MJSBikes97/roco222/robot_project/models/Arm Segment_2 v3.stl

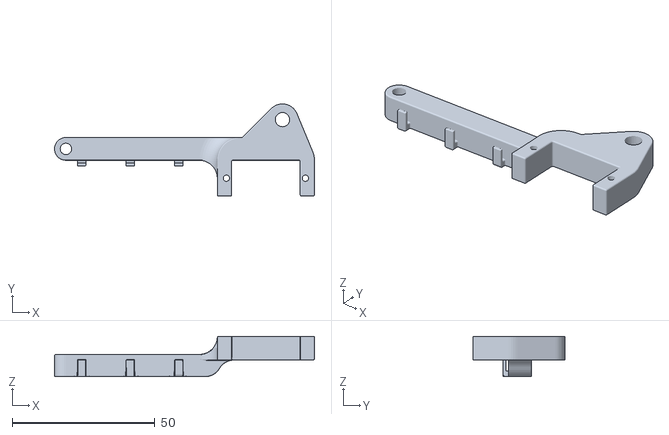
[picture p31: CAD file, 2018-01-10]
robot_project/models/Arm Segment_2 v3.stl
91.0 x 32.2 x 14.1
