MJSBikes97/roco222/robot_project/models/Spur Gear21.stl

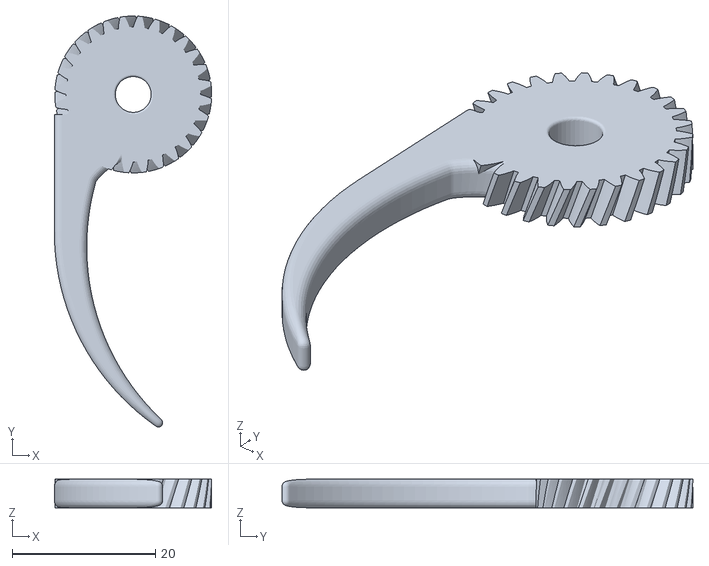
[picture p32: CAD file, 2018-01-10]
robot_project/models/Spur Gear21.stl
21.9 x 57.3 x 4.00
