MJSBikes97/roco222/robot_project/models/Arm_base_spacer_v1.stl

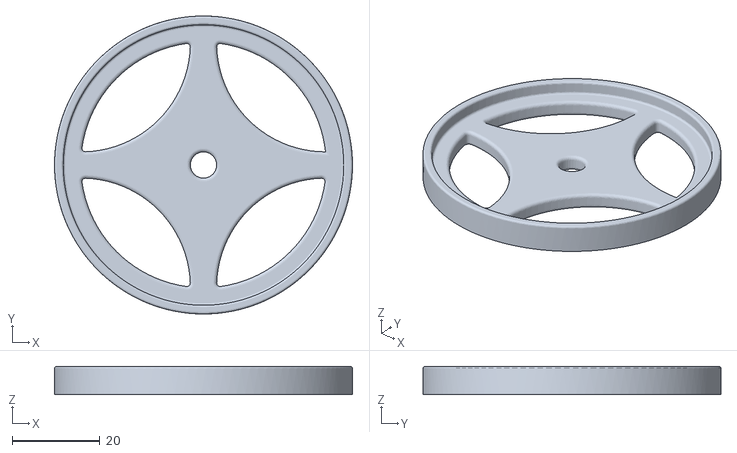
[picture p33: CAD file, 2018-01-10]
robot_project/models/Arm_base_spacer_v1.stl
68.0 x 68.0 x 6.50
