MJSBikes97/roco222/robot_project/models/Arm baseplate v2.stl

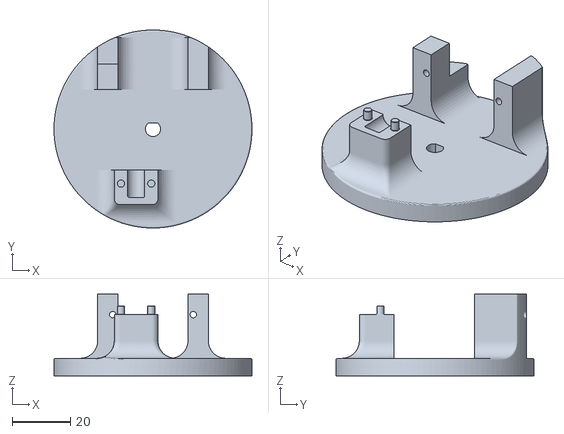
[picture p34: CAD file, 2018-01-10]
robot_project/models/Arm baseplate v2.stl
68.0 x 68.0 x 28.0
