MJSBikes97/roco222/robot_project/models/Arm Segment_1 v3.stl

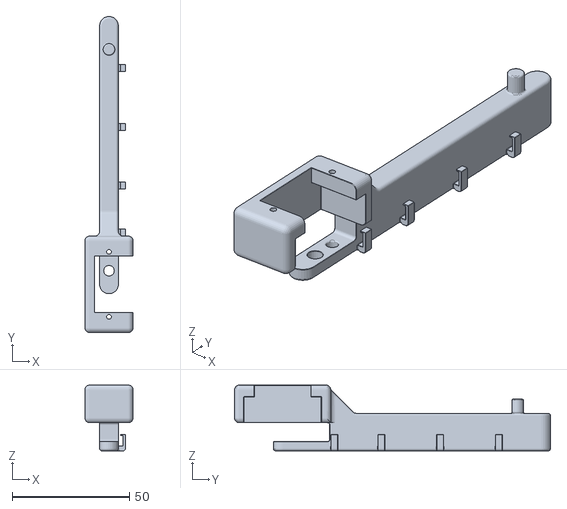
[picture p35: CAD file, 2018-01-10]
robot_project/models/Arm Segment_1 v3.stl
20.5 x 134.5 x 28.0
