MJSBikes97/roco222/robot_project/models/Spur Gear11.stl

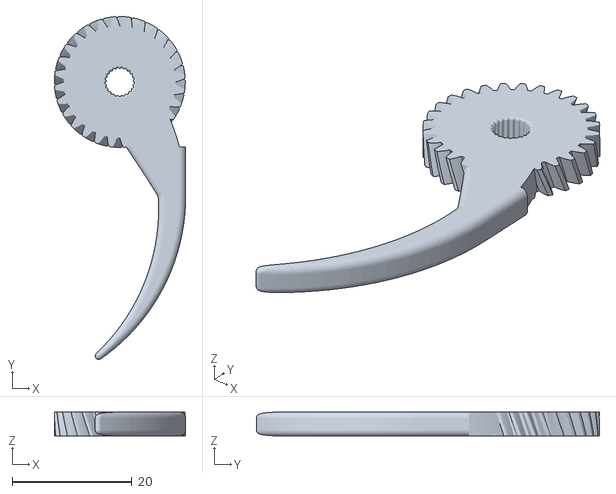
[picture p36: CAD file, 2018-01-10]
robot_project/models/Spur Gear11.stl
21.9 x 57.3 x 4.00
