MJSBikes97/roco222/robot_project/models/Base_boss_v1.stl

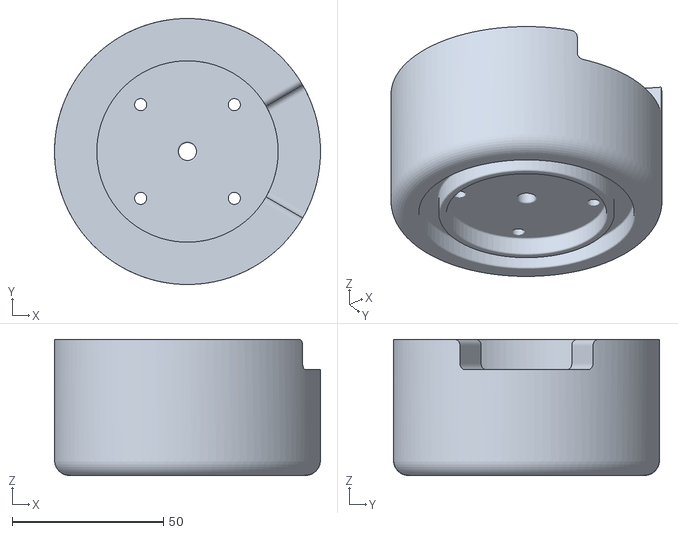
[picture p37: CAD file, 2018-01-10]
robot_project/models/Base_boss_v1.stl
88.0 x 88.0 x 45.0
