MJSBikes97/roco222/lab-journal/matt/IMG_20180109_122805.jpg

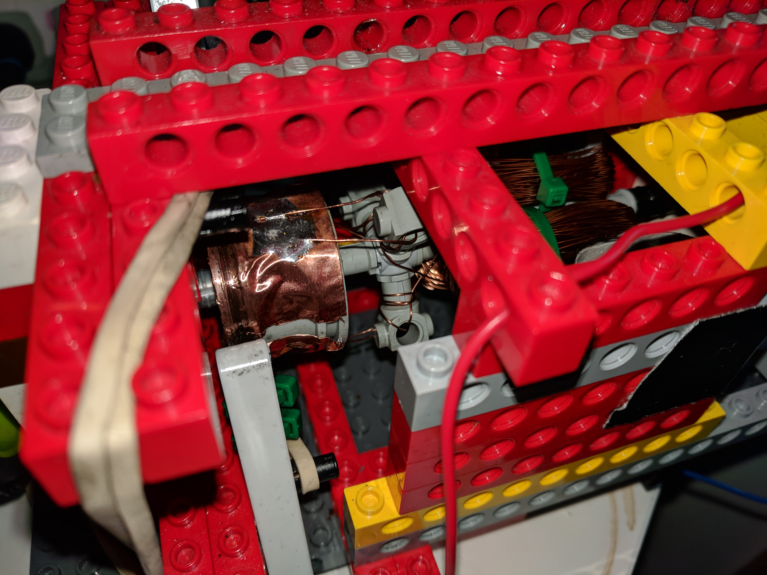
lab-journal/matt/IMG_20180109_122805.jpg
