MJSBikes97/roco222/lab-journal/matt/IMG_20180109_122829.jpg

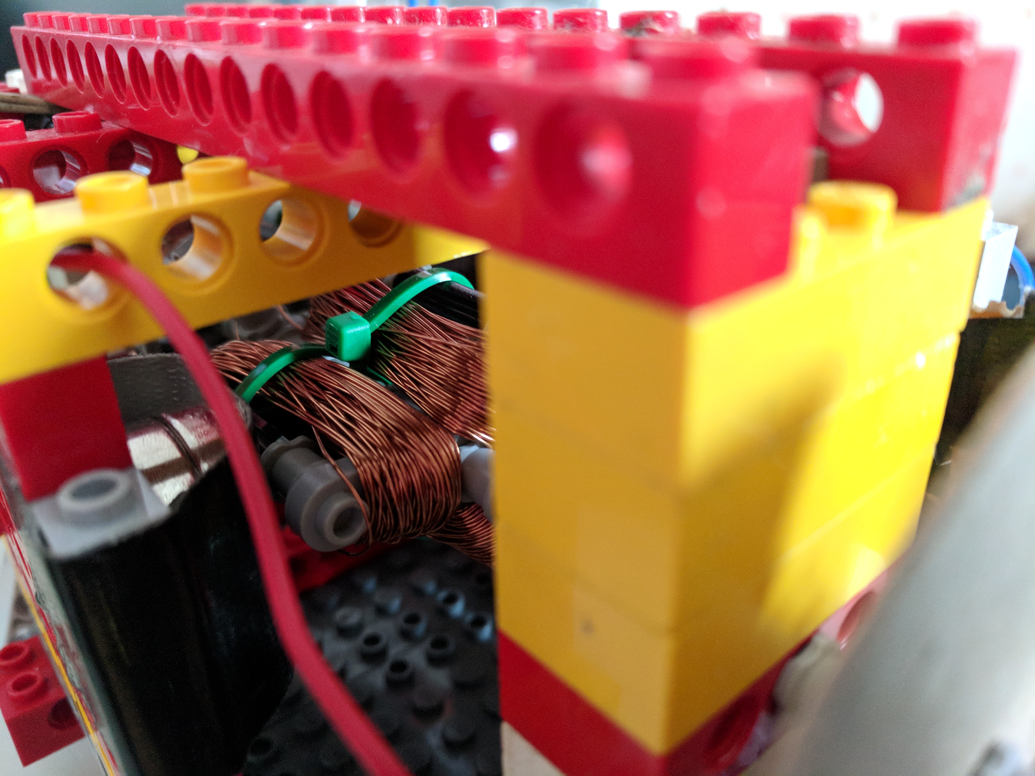
lab-journal/matt/IMG_20180109_122829.jpg
