MJSBikes97/roco222/lab-journal/matt/IMG_20180109_123024.jpg

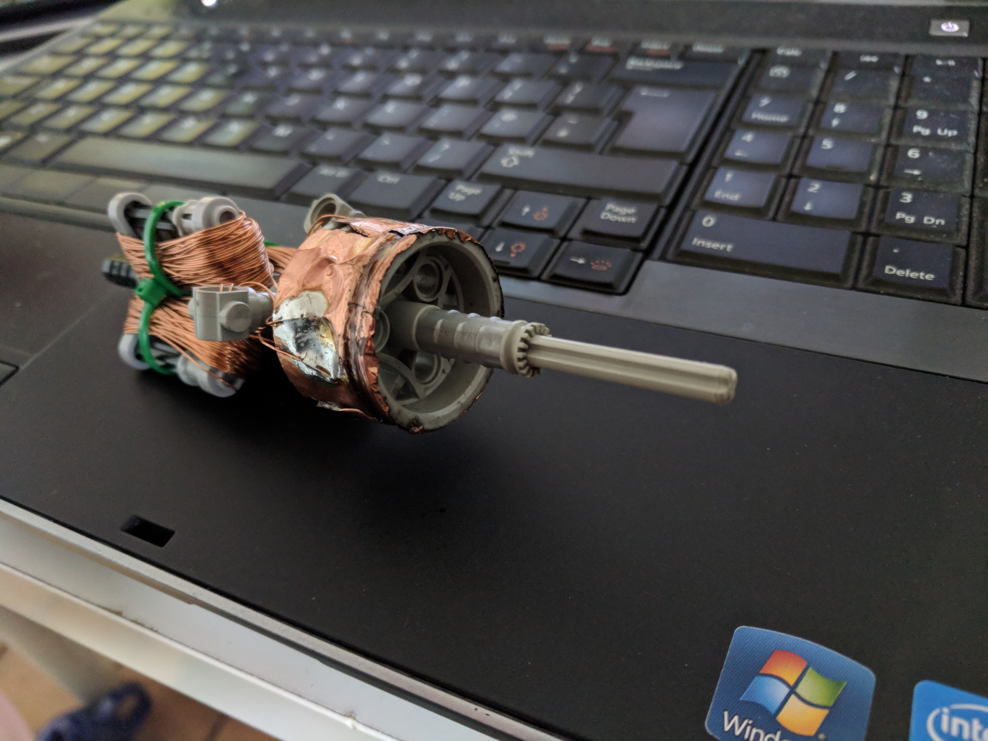
lab-journal/matt/IMG_20180109_123024.jpg
