MJSBikes97/roco222/(commit log)

2017-10-13 Added some info about DC Motors and some helpful Images! - MJS
2017-10-26 added info about final version motor and adding encoder new file - encoder test script MJS
2017-11-02 Added Stepper Motor Lab - MJS
2017-11-09 Added 2 new arduino files for Servo project and corresponding info in Journal -MJS
2017-12-06 Added sections on ROS and Motor v4
2017-12-07 Opened New section on RViz and URDF
2017-12-07 Added example URDF file
    [robot-arm.urdf]
2017-12-07 Added Screenshot of RViz and joint_state_publisher running with URDF
2017-12-07 Added 2-Segment URDF file to test 2DOF with RViz
    [2-segment-arm.urdf]
2017-12-14 edited 2-segment URDF to have correct shape and joint pos
    [2-segment-arm.urdf]
2017-12-16 Added microstepping script for arduino w/DFRobot motor driver
2017-12-17 Added positional test script for use with pot; dir control not working
    [stepper_positional_test.ino]
2017-12-17 Created launch file for 3dof arm testing
2017-12-17 Created accurate URDF for 3dof arm
    [3dof_arm.urdf]
2018-01-03 Added Working 4DOF arduino node with stepper control
2018-01-05 Added URDF and Arduino node for 4DOF arm
    [4dof_arm.urdf]
2018-01-05 Updated Journal; added info on Arm design and programming
2018-01-09 Added images of DC Motor v4
2018-01-09 Added photos of Lego arm design
2018-01-09 Added photos of lego arm to Journal
2018-01-09 Added URDF snippets to Journal
2018-01-09 Added Video and more info on DC Motors
2018-01-10 Added further info and 2 videos for DC motors
2018-01-10 Added characteristic graph for v4 motor
2018-01-10 Added Arm stl files
    [Arm Segment_1 v3.stl, Arm Segment_2 v3.stl, Arm baseplate v2.stl, Arm_base_spacer_v1.stl, Base_boss_v1.stl, Spur Gear11.stl, Spur Gear21.stl]
2018-01-10 Added info about the URDF of the final robot arm
2018-01-10 Added Sinusoidal Servo movement script
2018-01-11 Added arm CAD renders
2018-01-11 Journal updated with CAD renders and animation of arm
2018-01-11 Added sine servo video link and fixed duplicate render image issue
2018-01-11 added photos of A4988 and encoder disc
2018-01-11 Added close up photos of robot arm arrangement
2018-01-11 Added more pictures of final arm
2018-01-11 Inserted A4988 Truth Table
2018-01-11 More renders of Robot Arm
2018-01-11 Added 2 more renders of Arm design
2018-01-11 Added broken stepper code for comparison
